SukkoPera/plipbox/plipbox.kicad_pcb

## KiCad design plipbox.kicad_pcb (2023-02-28)

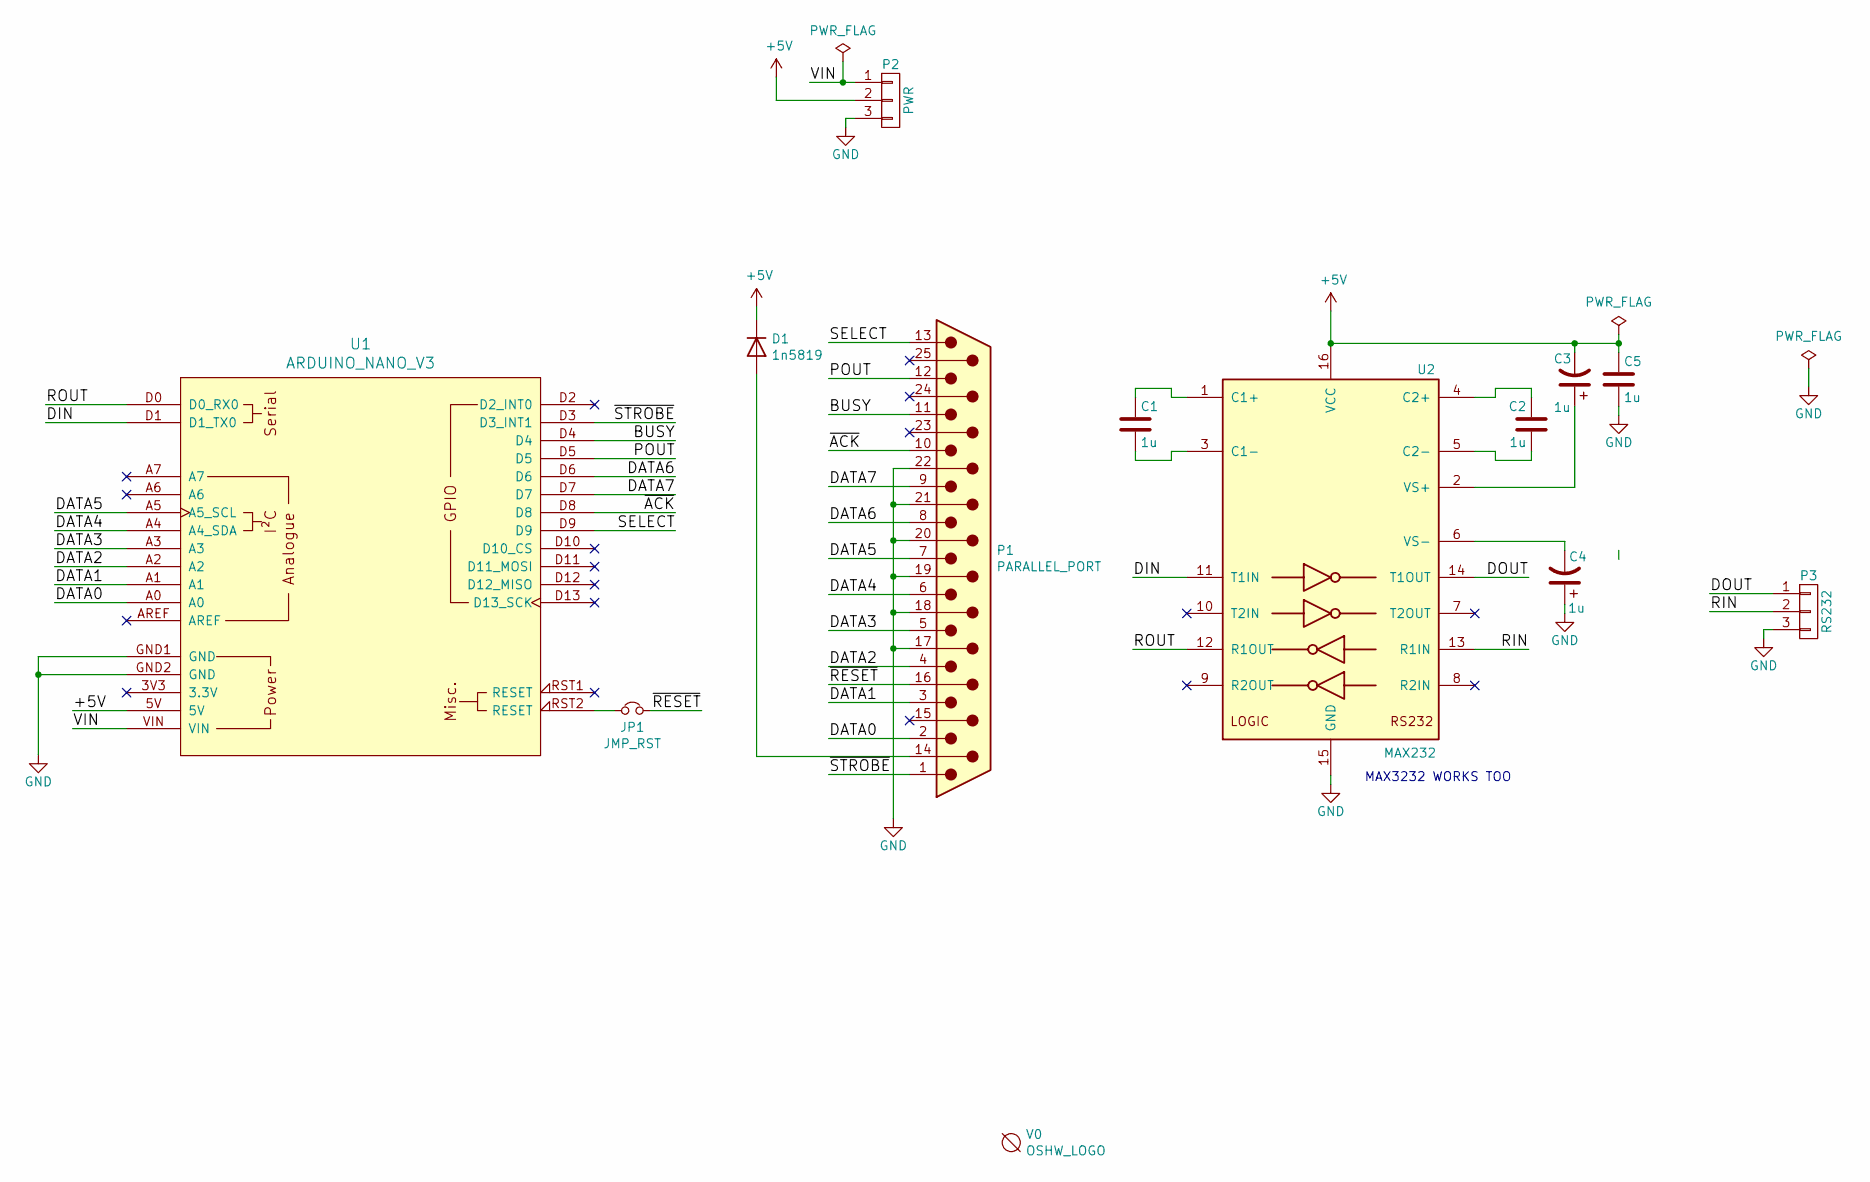
[picture p1: schematic plipbox.sch]

Parts:
C1, C2, C3, C4, C5: 1u; C_0805_2012Metric_Pad1.18x1.45mm_HandSolder
D1: 1n5819; D_SMA
JP1: JMP_RST; SolderJumper-2_P1.3mm_Open_RoundedPad1.0x1.5mm
P1: PARALLEL_PORT; DSUB-25_Male_EdgeMount_P2.77mm
P2: PWR; Pin_Header_Straight_1x03-ModSilkS
P3: RS232; Pin_Header_Straight_1x03-ModSilkS
U1: ARDUINO_NANO_V3; Arduino_Nano_Socket
U2: MAX232; SOIC-16_3.9x9.9mm_P1.27mm
V0: OSHW_LOGO; OSHW-Logo2_9.8x8mm_Copper

Connections:
+5V: C3.2, C5.1, D1.1 (K), P2.2, U1.5V, U2.16 (VCC)
/BUSY: P1.11, U1.D4
/DATA0: P1.2, U1.A0
/DATA1: P1.3, U1.A1
/DATA2: P1.4, U1.A2
/DATA3: P1.5, U1.A3
/DATA4: P1.6, U1.A4 (A4_SDA)
/DATA5: P1.7, U1.A5 (A5_SCL)
/DATA6: P1.8, U1.D6
/DATA7: P1.9, U1.D7
/DIN: U1.D1 (D1_TX0), U2.11 (T1IN)
/DOUT: P3.1, U2.14 (T1OUT)
/POUT: P1.12, U1.D5
/RIN: P3.2, U2.13 (R1IN)
/ROUT: U1.D0 (D0_RX0), U2.12 (R1OUT)
/SELECT: P1.13, U1.D9
/VIN: P2.1, U1.VIN
/~ACK: P1.10, U1.D8
/~RESET: JP1.2, P1.16
/~STROBE: P1.1, U1.D3 (D3_INT1)
GND: C4.1, C5.2, P1.17, P1.18, P1.19, P1.20, P1.21, P1.22, P2.3, P3.3, U1.GND1 (GND), U1.GND2 (GND), U2.15 (GND)
unnamed: C1.1, U2.1 (C1+)
unnamed: C1.2, U2.3 (C1-)
unnamed: C2.1, U2.4 (C2+)
unnamed: C2.2, U2.5 (C2-)
unnamed: C3.1, U2.2 (VS+)
unnamed: C4.2, U2.6 (VS-)
unnamed: D1.2 (A), P1.14
unnamed: JP1.1, U1.RST2 (RESET)

Notes on the sheet:
MAX3232 WORKS TOO

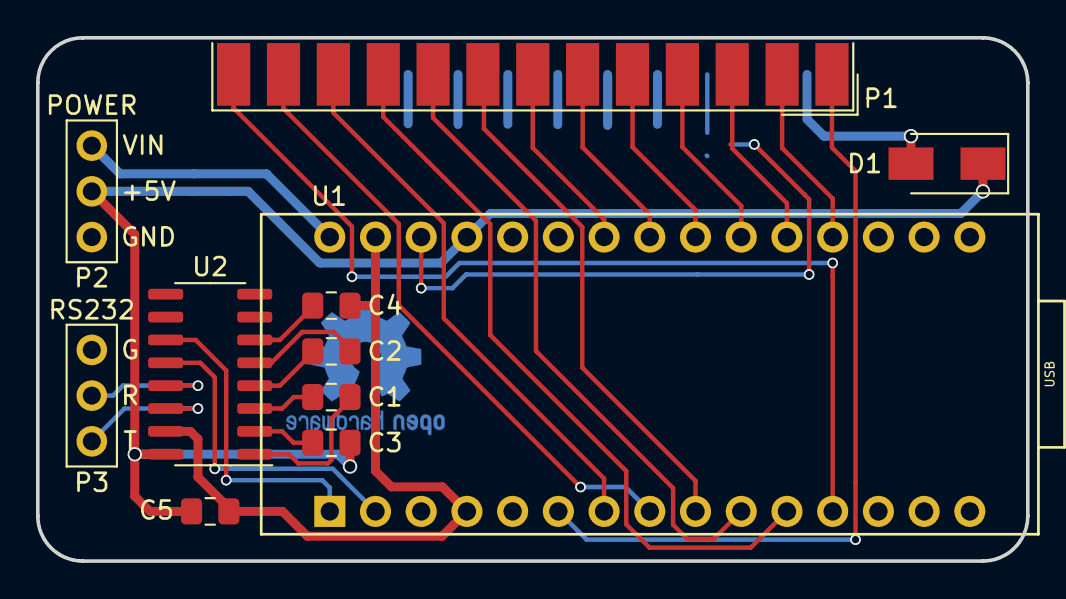
[picture p2: board plipbox.kicad_pcb from above]

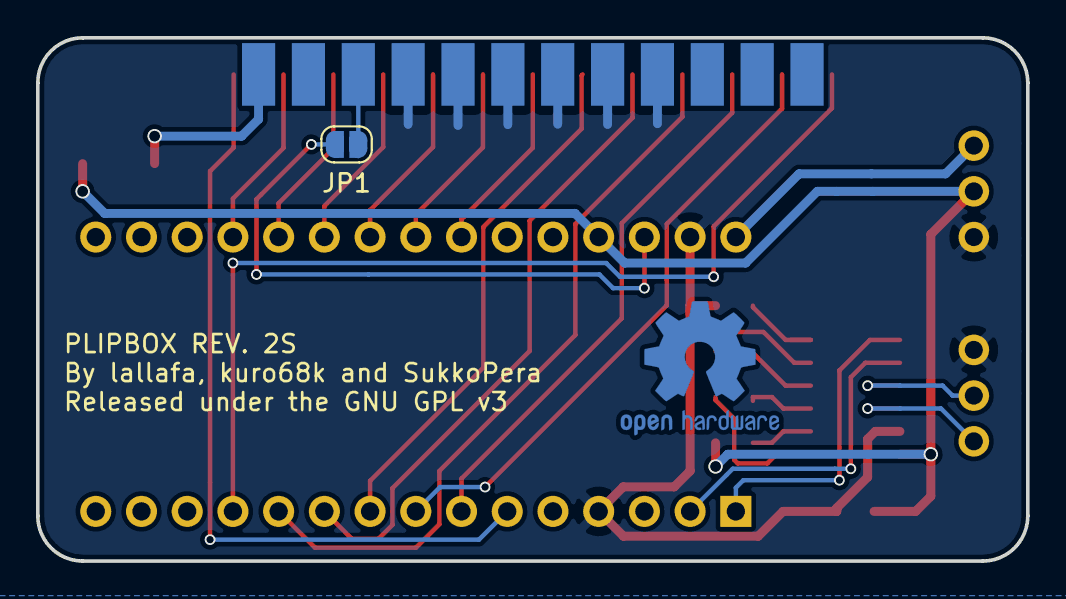
[picture p3: board plipbox.kicad_pcb from below]

Board: 2 copper layers, 55.0 x 29.1 mm, 13 parts (2 on the bottom side), 29 nets.
