SukkoPera/plipbox/(commit log)

2020-12-31 Use edge connector, use MAX232 & other minor tweaks
    [plipbox.kicad_pcb, plipbox.sch]
2021-08-31 Add diode and fix C3 C3 was WRONG in Rev.1S, it needs to be between pin 2 of U1 and VCC, not GND. The diode should only be mounted if the Amiga is modded so that power on the +5V line is not limited.
    [plipbox.kicad_pcb, plipbox.sch]
2023-02-28 Add reset jumper and ready for V2S
    [plipbox.kicad_pcb, plipbox.sch]
