SukkoPera/plipbox/(notices)

Notices in the files:
plipbox.sch:
Released under the GNU GPL v3
